long5021314/em-line-follower/src/CORE/OTHER/motor.c

#include "motor.h"


void motor_init(u16 arr,u16 psc)
{  
	GPIO_InitTypeDef GPIO_InitStructure;   //个结构体声明
	TIM_TimeBaseInitTypeDef  TIM_TimeBaseStructure;
	TIM_OCInitTypeDef  TIM_OCInitStructure;

	RCC_APB1PeriphClockCmd(RCC_APB1Periph_TIM4, ENABLE);  //使能TIM4时钟
 	RCC_APB2PeriphClockCmd(RCC_APB2Periph_GPIOB|RCC_APB2Periph_AFIO, ENABLE);  //使能GPIO外设和AFIO复用功能模块时钟使能

   //设置该引脚为复用输出功能,输出TIM3 CH2的PWM脉冲波形
	GPIO_InitStructure.GPIO_Pin = GPIO_Pin_6|GPIO_Pin_7|GPIO_Pin_8|GPIO_Pin_9; //从PB6，PB7，PB8，PB9输出pwm脉冲
	GPIO_InitStructure.GPIO_Mode = GPIO_Mode_AF_PP;  //复用推挽输出  设置模式
	GPIO_InitStructure.GPIO_Speed = GPIO_Speed_50MHz;   //设置速度
	GPIO_Init(GPIOB, &GPIO_InitStructure);    //传入结构体进行寄存器初始化
	

	TIM_TimeBaseStructure.TIM_Period = arr; //设置在下一个更新事件装入活动的自动重装载寄存器周期的值	 计数100个
	TIM_TimeBaseStructure.TIM_Prescaler = psc; //设置用来作为TIMx时钟频率除数的预分频值  不分频   每0.1ms计1个数
	TIM_TimeBaseStructure.TIM_ClockDivision = 0; //设置时钟分割:TDTS = Tck_tim
	TIM_TimeBaseStructure.TIM_CounterMode = TIM_CounterMode_Up;  //TIM向上计数模式
	TIM_TimeBaseInit(TIM4, &TIM_TimeBaseStructure); //根据TIM_TimeBaseInitStruct中指定的参数初始化TIMx的时间基数单位
	
	 
	TIM_OCInitStructure.TIM_OCMode = TIM_OCMode_PWM1; //选择定时器模式:TIM脉冲宽度调制模式2
	TIM_OCInitStructure.TIM_OutputState = TIM_OutputState_Enable; //比较输出使能
	TIM_OCInitStructure.TIM_Pulse = 0; //设置待装入捕获比较寄存器的脉冲值
	TIM_OCInitStructure.TIM_OCPolarity = TIM_OCPolarity_High; //输出极性:TIM输出比较极性高
	
	//4个通道初始化
	
	TIM_OC1Init(TIM4, &TIM_OCInitStructure);  //根据TIM_OCInitStruct中指定的参数初始化外设TIMx
	TIM_OC1PreloadConfig(TIM4, TIM_OCPreload_Enable);  //使能TIMx在CCR2上的预装载寄存器
	
	TIM_OC2Init(TIM4, &TIM_OCInitStructure);  //根据TIM_OCInitStruct中指定的参数初始化外设TIMx
	TIM_OC2PreloadConfig(TIM4, TIM_OCPreload_Enable);  //使能TIMx在CCR2上的预装载寄存器
	
	TIM_OC3Init(TIM4, &TIM_OCInitStructure);  //根据TIM_OCInitStruct中指定的参数初始化外设TIMx
	TIM_OC3PreloadConfig(TIM4, TIM_OCPreload_Enable);  //使能TIMx在CCR2上的预装载寄存器
	
	TIM_OC4Init(TIM4, &TIM_OCInitStructure);  //根据TIM_OCInitStruct中指定的参数初始化外设TIMx
	TIM_OC4PreloadConfig(TIM4, TIM_OCPreload_Enable);  //使能TIMx在CCR2上的预装载寄存器
	
	TIM_ARRPreloadConfig(TIM4, ENABLE); //使能TIMx在ARR上的预装载寄存器
	
	TIM_Cmd(TIM4, ENABLE);  //使能TIMx外设

}

//电机速度设置
void motor_control(int16_t leftpwm,int16_t rightpwm)
{
	//电机pwm限幅
	if(leftpwm>=Speed_Max)  leftpwm   =  Speed_Max;
	if(leftpwm<=-Speed_Max) leftpwm   = -Speed_Max;
	if(rightpwm>=Speed_Max)  rightpwm =  Speed_Max;
	if(rightpwm<=-Speed_Max) rightpwm = -Speed_Max;
	
	if(leftpwm>=0)
	{
		TIM_SetCompare1(TIM4,leftpwm);
//		TIM_SetCompare1(TIM4,2000);
		TIM_SetCompare2(TIM4,0);
	}
		
	else
	{
		TIM_SetCompare1(TIM4,0);
		TIM_SetCompare2(TIM4,-leftpwm);
//		TIM_SetCompare2(TIM4,2000);
	}
	
	if(rightpwm>=0)
	{
		TIM_SetCompare3(TIM4,rightpwm);
		TIM_SetCompare4(TIM4,0);
	}
		
	else
	{
		TIM_SetCompare3(TIM4,0);
		TIM_SetCompare4(TIM4,-rightpwm);
	}
}


//停车
void stop(void)
{
	GPIO_InitTypeDef GPIO_InitStructure;
	RCC_APB2PeriphClockCmd(RCC_APB2Periph_GPIOB,ENABLE);     //打开外设GPIOB时钟
	GPIO_InitStructure.GPIO_Pin=GPIO_Pin_12;       //定义引脚
	GPIO_InitStructure.GPIO_Mode=GPIO_Mode_IPU;     //上拉输入
	GPIO_Init(GPIOB,&GPIO_InitStructure); //初始化引脚
	
	GPIO_SetBits(GPIOB,GPIO_Pin_12);
}
