long5021314/em-line-follower/src/CORE/OTHER/timer.c

#include "timer.h"

int Test;
int Timer_Stop;

void TIM3_isr_init(u16 arr,u16 psc)
{
     TIM_TimeBaseInitTypeDef  TIM_TimeBaseStructure;
     NVIC_InitTypeDef NVIC_InitStructure;
     
     RCC_APB1PeriphClockCmd(RCC_APB1Periph_TIM3, ENABLE); //时钟使能
     //定时器TIM3初始化
     TIM_TimeBaseStructure.TIM_Period = arr; //设置在下一个更新事件装入活动的自动重装载寄存器周期的值 
     TIM_TimeBaseStructure.TIM_Prescaler =psc; //设置用来作为TIMx时钟频率除数的预分频值
     TIM_TimeBaseStructure.TIM_ClockDivision = TIM_CKD_DIV1; //设置时钟分割:TDTS = Tck_tim
     TIM_TimeBaseStructure.TIM_CounterMode = TIM_CounterMode_Up;  //TIM向上计数模式
     TIM_TimeBaseInit(TIM3, &TIM_TimeBaseStructure); //根据指定的参数初始化TIMx的时间基数单位
     
     TIM_ITConfig(TIM3,TIM_IT_Update,ENABLE ); //使能指定的TIM3中断,允许更新中断
     //中断优先级NVIC设置
     NVIC_InitStructure.NVIC_IRQChannel = TIM3_IRQn;  //TIM3中断
     NVIC_InitStructure.NVIC_IRQChannelPreemptionPriority = 0;  //先占优先级0级
     NVIC_InitStructure.NVIC_IRQChannelSubPriority = 3;  //从优先级3级
     NVIC_InitStructure.NVIC_IRQChannelCmd = ENABLE; //IRQ通道被使能
     NVIC_Init(&NVIC_InitStructure);  //初始化NVIC寄存器
     
     TIM_Cmd(TIM3, ENABLE);  //使能TIMx      
 }
 
 
//定时器3中断服务程序
void TIM3_IRQHandler(void)   //TIM3中断
{
    if (TIM_GetITStatus(TIM3, TIM_IT_Update) != RESET)  //检查TIM3更新中断发生与否
    {
          TIM_ClearITPendingBit(TIM3, TIM_IT_Update  );  //清除TIMx更新中断标志 
			
		if(Test == 0)
		{
			Test = 1;
			GPIO_ResetBits(GPIOC,GPIO_Pin_13);	
      		
		}
		
		else	if(Test == 1)
		{
			Test = 0;
			GPIO_SetBits(GPIOC,GPIO_Pin_13);		
		}
			Timer_Stop++;
		
//		if(Timer_Stop>58)
//		{
//			motor_control(0, 0);//电机控制
//			
//			while(1);
//			
//		}
			
    }
		

//		control();
}
