long5021314/em-line-follower/(commit log)

2026-11-08 电磁循迹小车：STM32F103 差比和 + PD + 弯道切内，单圈 42.985s
    - 差比和归一化、开机静止零点（等车放稳再采）
    - 位置式 PD（按时间求导 + 一阶低通）、死区 25
    - 转弯自动降速：满舵曲率 1.61/b -> 2.00/b
    - 弯道切内 CUT_IN：训练场 17.2s -> 16.4s
    - 丢线保持方向 + 冻结微分，避免直冲出赛道
    - 0.96 寸 SPI OLED 四套页面（调参/状态/记录/起跑）
    - 自动停车：STOP_MS 到点断电并显示用时
    含完整技术记录与现场照片。
2026-11-08 README：补充比赛录像关键帧
2026-11-08 源码转 UTF-8、补接线文档、默认宏对齐比赛配置
    - 23 个含中文注释的源文件从 GBK 转为 UTF-8（GitHub 上注释不再乱码，编译产物逐字节不变）
    - tools/build_fw.py 改为按字节替换 sys.c，不再假设源文件编码
    - 新增 docs/接线.md：引脚表、OLED 七针接法、排障
    - main.c 默认 SHOW_ON_OLED 改为 3，无参数编译即可复现 hex/ 里的比赛固件
    - README：补源码编码说明与复现校验（md5）
